jwerzowa/Lobo_Sat_EPS_V1/EPS_2S2P_KiCad_Kit/datasheets/README.md

# Datasheets

Put the PDFs here (Claude Code uses them to confirm pinouts). Suggested file names in brackets.
Links were correct when written; if one moved, search the manufacturer site for the MPN.

| Part | File | Source |
|---|---|---|
| LT3652 | `LT3652.pdf` | https://www.analog.com/media/en/technical-documentation/data-sheets/3652fe.pdf |
| S-8252 | `S-8252.pdf` | https://www.ablic.com/en/doc/datasheet/battery_protection/S8252_E.pdf |
| BQ29209 | `BQ29209.pdf` | https://www.ti.com/lit/ds/symlink/bq29209.pdf |
| FS8205A | `FS8205A.pdf` | Fortune Semiconductor (or the distributor page you bought from) |
| LMZM33602 | `LMZM33602.pdf` | https://www.ti.com/lit/ds/symlink/lmzm33602.pdf |
| TPS2553 | `TPS2553.pdf` | https://www.ti.com/lit/ds/symlink/tps2553.pdf |
| ADS1015 | `ADS1015.pdf` | https://www.ti.com/lit/ds/symlink/ads1015.pdf |
| ACS37612 | `ACS37612.pdf` | https://www.allegromicro.com (search ACS37612) |
| AO3400A / AO3401A | `AO3400A.pdf`, `AO3401A.pdf` | https://www.aosmd.com |
| LM393 | `LM393.pdf` | https://www.ti.com/lit/ds/symlink/lm393.pdf |
| SMBJ15A | `SMBJ.pdf` | Littelfuse SMBJ series |
| SS-5GL | `SS-5GL.pdf` | Omron SS series |
| 0466 fuse / 0ZCJ PTC | `0466.pdf`, `0ZCJ.pdf` | Littelfuse / Bel Fuse |
| NCP18XH103F03RB | `NCP18.pdf` | Murata |
| Keystone 18650 clip | `Keystone_18650.pdf` | Keystone Electronics (your exact MPN) |
| WSL2512, STPS140Z, CMSH3-40MA | as named | Vishay / ST / Central |
