jwerzowa/Lobo_Sat_EPS_V1/LINK_REPORT.md

# LINK_REPORT.md

Project: `/Users/julienwerzowa/Desktop/Projects/PCB/EPS_Lobosat_V1`

- Symbol libs in sym-lib-table: 1 | footprint libs in fp-lib-table: 1
- Symbols checked: 15 | with problems: 1

## Symbols

| Lib | Symbol | Footprint | Status | Notes |
|---|---|---|---|---|
| EPS_Symbols | 0ZCJ0100FF2E | EPS_Footprints:RESC3216X125N | OK |  |
| EPS_Symbols | 7447789004 | EPS_Footprints:WE-PD_7332R | OK |  |
| EPS_Symbols | ADS1015IRUGR | EPS_Footprints:IC_ADS1015IRUGR | OK |  |
| EPS_Symbols | BQ29209DRBR | EPS_Footprints:SON65P300X300X100-9N | OK |  |
| EPS_Symbols | CMSH3-40MA | EPS_Footprints:CR_SMA-CMSH3-40MA_CNS | OK |  |
| EPS_Symbols | FS8205A | EPS_Footprints:SOP65P640X120-8N | OK |  |
| EPS_Symbols | INA228AIDGSR | EPS_Footprints:VSSOP10_DGS_TEX | OK |  |
| EPS_Symbols | LMZM33602RLRR | EPS_Footprints:VREG_LMZM33602RLRR | OK | pads without pin (check EP/mounting): 12, 13 |
| EPS_Symbols | LT3652EMSE_PBF | EPS_Footprints:MSOP-12_MSE | OK |  |
| EPS_Symbols | NCP18XH103F03RB | EPS_Footprints:THRMC1608X95N | OK |  |
| EPS_Symbols | S-8252AAC-M6T1U | EPS_Footprints:SOT236-A-PKG_MP006-A-P-SD-2.1_ABL | OK |  |
| EPS_Symbols | SMBJ15A | EPS_Footprints:DIOM4336X265N | OK |  |
| EPS_Symbols | SS34 | EPS_Footprints:DIOM7959X265N | OK |  |
| EPS_Symbols | STPS140ZY | EPS_Footprints:SOD123_2P8X1P7_STM | OK |  |
| EPS_Symbols | TPS2553DBVR | Package_TO_SOT_SMD:SOT-23-6 | UNKNOWN FP LIB 'Package_TO_SOT_SMD' |  |
