jwerzowa/Lobo_Sat_EPS_V1/datasheets/README.md

# Datasheets

PDFs are **not committed** (gitignored). Run `bash scripts/fetch_datasheets.sh` to download the
ones that allow scripted downloads; get the rest by hand and save them here under the file name
shown. Claude Code uses them to confirm pinouts, so the more are here, the better.

| Part | File | Source | Auto-fetch |
|---|---|---|---|
| LT3652 | `LT3652.pdf` | https://www.analog.com/media/en/technical-documentation/data-sheets/3652fe.pdf | **No** (analog.com blocks scripts) |
| S-8252 | `S-8252.pdf` | https://www.ablic.com/en/doc/datasheet/battery_protection/S8252_E.pdf | yes |
| BQ29209 | `BQ29209.pdf` | https://www.ti.com/lit/ds/symlink/bq29209.pdf | yes |
| FS8205A | `FS8205A.pdf` | Fortune Semiconductor / the distributor you buy from | **No** |
| LMZM33602 | `LMZM33602.pdf` | https://www.ti.com/lit/ds/symlink/lmzm33602.pdf | yes |
| TPS2553 | `TPS2553.pdf` | https://www.ti.com/lit/ds/symlink/tps2553.pdf | yes |
| INA228 | `INA228.pdf` | https://www.ti.com/lit/ds/symlink/ina228.pdf | yes |
| ADS1015 | `ADS1015.pdf` | https://www.ti.com/lit/ds/symlink/ads1015.pdf | yes |
| AO3400A / AO3401A | `AO3400A.pdf`, `AO3401A.pdf` | https://www.aosmd.com | yes |
| LM393 | `LM393.pdf` | https://www.ti.com/lit/ds/symlink/lm393.pdf | yes |
| SS-5GL | `SS-5GL.pdf` | https://omronfs.omron.com/en_US/ecb/products/pdf/en-ss.pdf | yes |
| SMBJ15A | `SMBJ.pdf` | Littelfuse SMBJ series | No |
| 0466 fuse / 0ZCJ PTC | `0466.pdf`, `0ZCJ.pdf` | Littelfuse / Bel Fuse | No |
| NCP18XH103F03RB | `NCP18.pdf` | Murata | No (Murata blocks scripts) |
| Keystone 1042 18650 holder | `Keystone_1042.pdf` | Keystone Electronics | No |
| WSL2512, STPS140Z, CMSH3-40MA, SS34, 7447789004 | as named | Vishay / ST / Central / onsemi / Würth | No |
