jwerzowa/Lobo_Sat_EPS_V1/EPS_2S2P_KiCad_Kit/images/battery_protection_topology.png

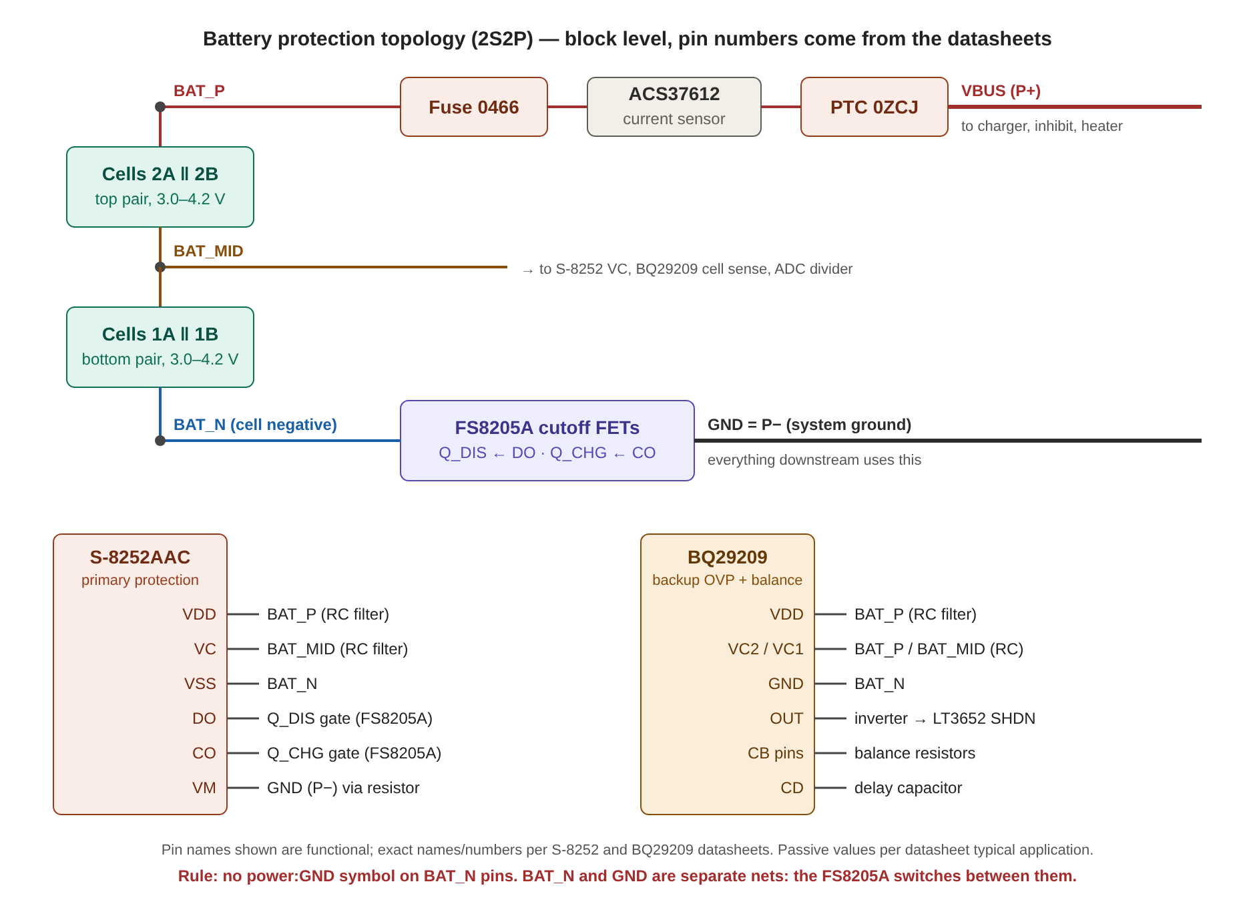
EPS_2S2P_KiCad_Kit/images/battery_protection_topology.png
