jwerzowa/Lobo_Sat_EPS_V1/MISSING_PARTS.md

# MISSING_PARTS.md

Generated by Claude Code on: 2026-10-23 (updated 2026-10-24: heater dropped)
KiCad version: 10.0.4
Library audit: `python3 scripts/audit_libs.py --project . --libs libs/symbols --out LINK_REPORT.md`
(15 symbols checked, all link symbol → footprint → 3D model. The one "problem" listed is TPS2553
using KiCad's built-in `Package_TO_SOT_SMD:SOT-23-6`, which the audit script can't see.)

## 1. Parts not found at all

| MPN | Needed for (sheet / function) | What's missing | Where to get it | Priority |
|---|---|---|---|---|
| SS-5GL (Omron) | launch_inhibit / RBF + deployment switch | footprint + 3D (symbol = KiCad `Switch:SW_SPDT`) | Omron / SnapEDA. Note SS-5GL has **solder** terminals; the PCB-terminal version is **SS-5GLD** | Blocking for layout |
| Keystone 18650 clip | battery / cell holders | exact MPN. Using KiCad's `Battery:BatteryHolder_Keystone_1042_1x18650` footprint | Keystone. Confirm 1042 is the holder you want | High |
| Littelfuse 0466 (rating TBD) | battery / main + per-cell fuses | rating → MPN. Using `Device:Fuse` + KiCad `Fuse_1206_3216Metric` | Littelfuse 0466 series | High |
| 2N7002-type N-FET ×2 | charger / SHDN inverters (Q201, Q202) | part choice (docs/06 #9). Placed as `Transistor_FET:2N7002`, Value = TBD | any SOT-23 logic-level N-FET, Vgs max ≥ 12 V | Medium |
| Connectors (solar in, 3 outputs, MCU) | solar_input, load_switches, telemetry | type (docs/06 #8). JST-PH 2-pin and 1×20 header used as **placeholders** | — | Medium |

## 2. Partially available

| MPN | Have | Missing | Workaround used |
|---|---|---|---|
| S-8252AAC-M6T1U | symbol + footprint downloaded for **S-8252AAZ**-M6T1U | AAC-specific download | Same SOT-23-6 pinout for the whole series (datasheet Table 6), so the symbol was renamed to AAC. **Not a part substitution**: BOM MPN is AAC (4.300 V / 2.400 V). AAZ would be 4.225 V |
| S-8252AAC, INA228, STPS140ZY, CMSH3-40MA | symbol, footprint | vendor 3D model | KiCad generic body (SOT-23-6, MSOP-10, SOD-123, SMA) copied to `libs/3d/` |
| TPS2553DBVR | datasheet | any symbol | Drawn in `consolidate_libs.py` from datasheet §6 (DBV: 1 IN, 2 GND, 3 EN, 4 FAULT, 5 ILIM, 6 OUT); KiCad SOT-23-6 footprint |
| SMBJ15A | footprint, 3D | symbol | Clone of KiCad `Device:D_Zener` (pin 1 = K) |
| 7447789004 | generic WE-PD 7332 symbol/footprint/3D | inductance confirmation | Value set to 4.7 µH from your old schematic. Check Würth datasheet: L and Isat ≥ 3 A |

## 3. Library problems (found and fixed in `scripts/consolidate_libs.py`, originals untouched)

| MPN | Problem | Evidence | Fix |
|---|---|---|---|
| BQ29209DRBR | Footprint thermal vias numbered 10–13, sitting inside EP pad 9 | They overlap pad 9 copper; datasheet: thermal pad = GND | Renumbered to pad 9 |
| CMSH3-40MA | Pins had no names, type "unspecified" | Symbol drawing: cathode bar on pin 1 side | Named 1 = K, 2 = A; type passive |
| STPS140ZY | Pin type "unspecified" | — | passive |
| S-8252 | VSS typed power_out, VM unspecified | datasheet Table 6 | VSS power_in, VM input |
| INA228AIDGSR | GND typed power_out | datasheet Table 5-1 | power_in |
| LT3652EMSE_PBF | BAT and VFB typed output | they are sense inputs | input |
| LMZM33602RLRR | ~50 duplicate VOUT/SW/PGND pins (thermal-via pads) all "output" → ERC conflicts | — | duplicates → passive, main VOUT → power_out |
| All parts | No footprint had a 3D model linked; symbols pointed at per-part footprint libs that weren't in any fp-lib-table | old ERC: 23 footprint_link_issues | One `EPS_Footprints` lib, `${KIPRJMOD}/libs/3d/...` paths |
| SS34 | Footprint is **SMC** (DIOM7959, 7.9 × 5.9 mm), parts list says SMA | footprint name / IPC size code | **Not fixed**: pick the package you will buy |
| SMBJ15A footprint | No polarity mark on silkscreen | footprint file | Not fixed: add a cathode mark when you lay out |

## 4. Datasheets missing from `datasheets/`

| MPN | Needed to confirm |
|---|---|
| LT3652 | **Most important.** SHDN threshold/abs max (R203 pull-up), TIMER cap value, boost cap value (0.1 µF used, some LT parts want 1 µF), VFB bias-current correction for the 154k/100k divider, 100 mV sense threshold. Pinout taken from the symbol + your earlier wiring |
| FS8205A | Pinout (1,8 D; 2,3 S1; 4 G1; 5 G2; 6,7 S2). Symbol drawing agrees, not checked against a datasheet |
| NCP18, 0466, 0ZCJ, Keystone, WSL2512, STPS140Z, CMSH3-40MA, SS34, 7447789004 | ratings only, pinouts are trivial |

## 5. Design questions raised while wiring

| Question | Sheet | What I did meanwhile |
|---|---|---|
| Old schematic had the **SMBJ15A TVS reversed** (K on GND) | solar_input | Fixed: K → VSOLAR_RAW |
| Old schematic had the **STPS140ZY boost diode reversed** (K on BAT) | charger | Fixed: A → VBUS, K → BOOST |
| Per-cell fuses "DNP by default" would leave every cell disconnected | battery | Fitted. Use a 0 Ω 1206 link if you don't want them |
| 5 V rail: LMZM33602 wants VIN ≥ 1.3 × VOUT = 6.5 V, pack goes down to 6.0 V | regulation | Built as asked; 5 V will drop out near empty. Consider over-discharge or a UVLO on EN |
| BQ29209 OUT is referenced to BAT_N, the inverter FET source is on GND (P−) | charger | OK while the FS8205A is on. If the charge FET is off, BAT_N and GND differ; check this case |
| S-8252 CO/DO swing to VDD (≤ 8.4 V); FS8205A Vgs max ±12 V | battery | OK, no action |
| Heater | — | Dropped 2026-10-24. J701 pin 17 (was HEATER_EN) is spare |
| ADS1015 AIN0 now measures VSOLAR (the kit's I_BAT input moved to the INA228) | telemetry | Divider 330k/47k |
| Old schematic had an extra CMSH3-40MA (CR3) from BAT to GND with no stated role | charger | Dropped. Tell me if it was meant as reverse-polarity protection |
