jwerzowa/Lobo_Sat_EPS_V1/EPS_2S2P_KiCad_Kit/templates/MISSING_PARTS.md

# MISSING_PARTS.md

Generated by Claude Code on: YYYY-MM-DD
KiCad version: x.y.z
Library audit run: `python3 scripts/audit_libs.py ...` (attach LINK_REPORT.md)

## 1. Parts not found at all

| MPN | Needed for (sheet / function) | What's missing (symbol / footprint / 3D) | Where to get it | Priority |
|---|---|---|---|---|
| e.g. S-8252AAC-M6T1U | battery / primary protection | symbol + footprint + 3D | SnapEDA, Ultra Librarian, ABLIC site | Blocking |

## 2. Partially available

| MPN | Have | Missing | Workaround used (if any) |
|---|---|---|---|
| e.g. BQ29209DRBR | symbol, footprint | 3D model | none, 3D view will show no body |

## 3. Library problems (found but wrong)

| MPN | Problem | Evidence | Suggested fix |
|---|---|---|---|
| e.g. LT3652EMSE#PBF | Symbol has no pin for exposed pad 13 | Footprint pad 13 exists, datasheet: EP = GND | Add pin 13 "GND_EP" to symbol |

## 4. Datasheets missing from `datasheets/`

| MPN | Needed to confirm |
|---|---|
| | |

## 5. Design questions raised while wiring

| Question | Sheet | What I did meanwhile |
|---|---|---|
| | | |
