jwerzowa/Lobo_Sat_EPS_V1/BOM.csv

Refs | Value | MPN | Manufacturer | Footprint | Qty | DNP | Description
BT301 | 18650 cell 1A | TBD (Keystone 1042?) | Keystone Electronics | Battery:BatteryHolder_Keystone_1042_1x18650 | 1 |  | LG MJ1 18650 in holder
BT302 | 18650 cell 1B | TBD (Keystone 1042?) | Keystone Electronics | Battery:BatteryHolder_Keystone_1042_1x18650 | 1 |  | LG MJ1 18650 in holder
BT303 | 18650 cell 2A | TBD (Keystone 1042?) | Keystone Electronics | Battery:BatteryHolder_Keystone_1042_1x18650 | 1 |  | LG MJ1 18650 in holder
BT304 | 18650 cell 2B | TBD (Keystone 1042?) | Keystone Electronics | Battery:BatteryHolder_Keystone_1042_1x18650 | 1 |  | LG MJ1 18650 in holder
C201 | 10uF 50V X7R | generic | generic | Capacitor_SMD:C_1210_3225Metric | 1 |  | VIN input cap
C202 | TBD | generic | generic | Capacitor_SMD:C_0805_2012Metric | 1 |  | TIMER cap: value per LT3652 datasheet
C203 | 0.1uF 25V X7R | generic | generic | Capacitor_SMD:C_0805_2012Metric | 1 |  | Boost cap (verify value vs datasheet)
C204 | 10uF 25V X7R | generic | generic | Capacitor_SMD:C_1206_3216Metric | 1 |  | BAT output cap
C301-C306,C601,C603,C605,C701-C705 | 0.1uF | generic | generic | Capacitor_SMD:C_0805_2012Metric | 14 |  | ADC input filter,ADS1015 VDD bypass,BQ29209 VC1-GND,BQ29209 VC2-VC1,BQ29209 VDD,IN bypass,INA228 VS bypass,S-8252 C1 (VDD-VSS),S-8252 C2 (VC-VSS)
C307 | 0.33uF | generic | generic | Capacitor_SMD:C_0805_2012Metric | 1 |  | BQ29209 delay ~3 s
C501 | 150pF | generic | generic | Capacitor_SMD:C_0805_2012Metric | 1 |  | CFF, rail A
C502,C503,C515,C516 | 4.7uF 50V X7R | generic | generic | Capacitor_SMD:C_1210_3225Metric | 4 |  | CIN (2 x 4.7 uF min)
C504-C507,C518-C521 | 22uF 25V X7R | generic | generic | Capacitor_SMD:C_1210_3225Metric | 8 |  | COUT
C517 | 100pF | generic | generic | Capacitor_SMD:C_0805_2012Metric | 1 |  | CFF, rail A
C602,C604,C606 | 10uF 16V X7R | generic | generic | Capacitor_SMD:C_1206_3216Metric | 3 |  | Output cap
D101 | SMBJ15A | SMBJ15A | Littelfuse | EPS_Footprints:DIOM4336X265N | 1 |  | 15 V standoff unidirectional TVS, SMB (pin 1 = K)
D102 | SS34 | SS34 | onsemi | EPS_Footprints:DIOM7959X265N | 1 |  | 40 V 3 A Schottky. NOTE footprint is SMC (7.9 x 5.9 mm), parts list says SMA
D201 | CMSH3-40MA | CMSH3-40MA TR13 PBFREE | Central Semiconductor | EPS_Footprints:CR_SMA-CMSH3-40MA_CNS | 1 |  | Catch diode
D202 | STPS140ZY | STPS140ZY | STMicroelectronics | EPS_Footprints:SOD123_2P8X1P7_STM | 1 |  | Boost diode, BAT -> BOOST
F301-F305 | TBD | 0466 series (rating TBD) | Littelfuse | Fuse:Fuse_1206_3216Metric | 5 |  | Main pack fuse,Per-cell fuse 1A,Per-cell fuse 1B,Per-cell fuse 2A,Per-cell fuse 2B
F306 | 0ZCJ0100FF2E | 0ZCJ0100FF2E | Bel Fuse | EPS_Footprints:RESC3216X125N | 1 |  | PTC, hold current may be too low (docs/06 #4)
J101 | SOLAR_IN | TBD | TBD | Connector_JST:JST_PH_B2B-PH-K_1x02_P2.00mm_Vertical | 1 |  | Solar panel input, 1 = +, 2 = -. Connector TBD
J601 | OUT_VID | TBD | TBD | Connector_JST:JST_PH_B2B-PH-K_1x02_P2.00mm_Vertical | 1 |  | VID output, 1 = +, 2 = GND. Connector TBD
J602 | OUT_TLM | TBD | TBD | Connector_JST:JST_PH_B2B-PH-K_1x02_P2.00mm_Vertical | 1 |  | TLM output, 1 = +, 2 = GND. Connector TBD
J603 | OUT_COM | TBD | TBD | Connector_JST:JST_PH_B2B-PH-K_1x02_P2.00mm_Vertical | 1 |  | COM output, 1 = +, 2 = GND. Connector TBD
J701 | MCU_IF | TBD | TBD | Connector_PinHeader_2.54mm:PinHeader_1x20_P2.54mm_Vertical | 1 |  | MCU / OBC interface, placeholder footprint
L201 | 4.7uH | 7447789004 | Wurth Elektronik | EPS_Footprints:WE-PD_7332R | 1 |  | WE-PD 7332 power inductor (verify 4.7 uH / Isat >= 3 A)
Q201,Q202 | TBD | TBD | TBD | Package_TO_SOT_SMD:SOT-23 | 2 |  | BQ29209 OVP -> SHDN inverter (docs/06 #9),MCU charger shutdown (docs/06 #9)
Q301 | FS8205A | FS8205A | Fortune Semiconductor | EPS_Footprints:SOP65P640X120-8N | 1 |  | Dual N-MOSFET common drain, TSSOP-8 (1,8 D; 2,3 S1; 4 G1; 5 G2; 6,7 S2)
Q401 | AO3401A | AO3401A | Alpha & Omega | Package_TO_SOT_SMD:SOT-23 | 1 |  | -4.0A Id, -30V Vds, P-Channel MOSFET, SOT-23
R201-R203,R601,R603,R605 | TBD | generic | generic | Resistor_SMD:R_0805_2012Metric | 6 |  | ILIM COM (docs/06 #5),ILIM TLM (docs/06 #5),ILIM VID (docs/06 #5),SHDN pull-up; check LT3652 SHDN threshold/abs max,VIN_REG divider bottom (docs/06 #3),VIN_REG divider top (docs/06 #3)
R204 | 1k | generic | generic | Resistor_SMD:R_0805_2012Metric | 1 |  | Gate series R, per BQ29209 Fig. 9
R205,R206,R401,R602,R604,R606 | 100k | generic | generic | Resistor_SMD:R_0805_2012Metric | 6 |  | Charger enabled while MCU is off,EN pull-down,Gate pull-down,Gate pull-up, FET off by default
R207 | 154k 1% | generic | generic | Resistor_SMD:R_0805_2012Metric | 1 |  | Float divider top
R208 | 100k 1% | generic | generic | Resistor_SMD:R_0805_2012Metric | 1 |  | Float divider bottom
R209 | 50m 1% | WSL2512R0500FEA | Vishay Dale | Resistor_SMD:R_2512_6332Metric | 1 |  | Charge current sense
R301 | 10m 1% | WSL2512R0100FEA | Vishay Dale | Resistor_SMD:R_2512_6332Metric | 1 |  | INA228 shunt (value proposed, confirm with fuse rating)
R302,R303 | 470 | generic | generic | Resistor_SMD:R_0805_2012Metric | 2 |  | S-8252 R1,S-8252 R2
R304 | 2k | generic | generic | Resistor_SMD:R_0805_2012Metric | 1 |  | S-8252 R3 (VM to EB-)
R305 | 160 | generic | generic | Resistor_SMD:R_0805_2012Metric | 1 |  | BQ29209 RCB2
R306 | 261 1% | generic | generic | Resistor_SMD:R_0805_2012Metric | 1 |  | BQ29209 RCB1 (datasheet 260)
R307,R308 | 100 | generic | generic | Resistor_SMD:R_0805_2012Metric | 2 |  | BQ29209 RCB,BQ29209 RVD
R309,R503,R509 | 10k 1% | generic | generic | Resistor_SMD:R_0805_2012Metric | 3 |  | NTC divider, ADS1015 supply as reference,RFBB, rail A
R501 | 133k 1% | generic | generic | Resistor_SMD:R_0805_2012Metric | 1 |  | RT, rail A
R502 | 23.2k 1% | generic | generic | Resistor_SMD:R_0805_2012Metric | 1 |  | RFBT, rail A = 3V3
R507 | 40.2k 1% | generic | generic | Resistor_SMD:R_0805_2012Metric | 1 |  | RFBT, rail A = 3V3
R508 | 88.7k 1% | generic | generic | Resistor_SMD:R_0805_2012Metric | 1 |  | RT, rail A
R701 | 330k 0.1% | generic | generic | Resistor_SMD:R_0805_2012Metric | 1 |  | VSOLAR divider top
R702 | 47k 0.1% | generic | generic | Resistor_SMD:R_0805_2012Metric | 1 |  | VSOLAR divider bottom
R703 | 200k 0.1% | generic | generic | Resistor_SMD:R_0805_2012Metric | 1 |  | VBUS divider top
R704-R706 | 100k 0.1% | generic | generic | Resistor_SMD:R_0805_2012Metric | 3 |  | BAT_MID divider bottom,BAT_MID divider top,VBUS divider bottom
R707-R715 | 10k | generic | generic | Resistor_SMD:R_0805_2012Metric | 9 |  | Pull-up ADC_ALERT_N,Pull-up CHG_FAULT_N,Pull-up CHG_STAT_N,Pull-up FLT_COM_N,Pull-up FLT_TLM_N,Pull-up FLT_VID_N,Pull-up INA_ALERT_N,Pull-up PG_RAIL_A,Pull-up PG_RAIL_B
R716,R717 | 4.7k | generic | generic | Resistor_SMD:R_0805_2012Metric | 2 |  | I2C pull-up
SW401 | SS-5GL | SS-5GL | Omron |  | 1 |  | Deployment / RBF microswitch, 2 = COM, 1 = NC, 3 = NO
TH201,TH301 | 10k NTC | NCP18XH103F03RB | Murata | EPS_Footprints:THRMC1608X95N | 2 |  | Charge NTC, mount against the cells,Telemetry NTC, mount against the cells
U201 | LT3652EMSE#PBF | LT3652EMSE#PBF | Analog Devices | EPS_Footprints:MSOP-12_MSE | 1 |  | Solar MPPT Li-ion charger, MSOP-12 exposed pad (pin 13 = EP = GND)
U301 | INA228 | INA228AIDGSR | Texas Instruments | EPS_Footprints:VSSOP10_DGS_TEX | 1 |  | 85 V 20-bit I2C power/energy/charge monitor, VSSOP-10
U302 | S-8252AAC-M6T1U | S-8252AAC-M6T1U | ABLIC | EPS_Footprints:SOT236-A-PKG_MP006-A-P-SD-2.1_ABL | 1 |  | 2-cell Li-ion protection, OC 4.300 V, OD 2.400 V, SOT-23-6
U303 | BQ29209DRBR | BQ29209DRBR | Texas Instruments | EPS_Footprints:SON65P300X300X100-9N | 1 |  | 2-cell backup overvoltage protection (4.30 V) + cell balancing, VSON-8
U501,U503 | LMZM33602 3V3 | LMZM33602RLRR | Texas Instruments | EPS_Footprints:VREG_LMZM33602RLRR | 2 |  | 36 V 2 A buck power module, QFN-18 (pads 12/13 = DNC, no symbol pin on purpose)
U601-U603 | TPS2553DBVR | TPS2553DBVR | Texas Instruments | Package_TO_SOT_SMD:SOT-23-6 | 3 |  | Current-limited load switch, EN active high, auto-retry, SOT-23-6
U701 | ADS1015 | ADS1015IRUGR | Texas Instruments | EPS_Footprints:IC_ADS1015IRUGR | 1 |  | 4-ch 12-bit I2C ADC, X2QFN-10
