jwerzowa/Lobo_Sat_EPS_V1/docs/05_parts_list.csv

Sheet | RefPrefix | MPN | Manufacturer | Description | Package | Qty | Library | DNP | Notes
solar_input | J | TBD | TBD | Solar panel input connector 2-pin | TBD | 1 | either | no | Connector type not chosen; use generic Conn_01x02 + note
solar_input | D | SMBJ15A | Littelfuse | TVS diode 15 V | SMB (DO-214AA) | 1 | downloaded | no | Panel Voc must stay below 15 V
solar_input | D | SS34 | generic | Schottky 3 A 40 V backfeed block | SMA (DO-214AC) | 1 | downloaded | no | One per panel string
charger | U | LT3652EMSE#PBF | Analog Devices | Solar MPPT Li-ion charger | MSOP-12 exposed pad | 1 | downloaded | no | EP to GND
charger | L | TBD | TBD | Power inductor ~4.7 uH >=3 A | TBD | 1 | either | no | Value per LT3652 datasheet
charger | D | STPS140ZY | STMicroelectronics | Boost diode | SOD-123 | 1 | downloaded | no
charger | D | CMSH3-40MA | Central Semiconductor | Schottky catch diode 3 A 40 V | SMA | 1 | downloaded | no | Confirm role vs SS34 in schematic
charger | C | TBD | generic | 0.1 uF >=16 V boost capacitor | 0805 | 1 | builtin | no
charger | R | WSL2512R0500FEA | Vishay | Charge current sense resistor 50 mOhm | 2512 | 1 | downloaded | no
charger | R | TBD | generic | Float divider top 154 kOhm 1% | 0805 | 1 | builtin | no
charger | R | TBD | generic | Float divider bottom 100 kOhm 1% | 0805 | 1 | builtin | no
charger | R | TBD | generic | VIN_REG divider top (value TBD) | 0805 | 1 | builtin | no | Old 143k is WRONG for 2S
charger | R | TBD | generic | VIN_REG divider bottom (value TBD) | 0805 | 1 | builtin | no
charger | Q | TBD | generic | N-FET SHDN inverters (BQ29209 OVP + MCU) | SOT-23 | 2 | builtin | no | docs/06 #9
charger | TH | NCP18XH103F03RB | Murata | NTC 10 kOhm charge temperature | 0603 | 1 | downloaded | no | Mounted against cells
battery | BT | TBD | Keystone Electronics | 18650 battery clip/holder | per downloaded part | 4 | downloaded | no | Exact Keystone MPN from Julien's library
battery | U | S-8252AAC-M6T1U | ABLIC | 2-cell Li-ion protection (primary) | SOT-23-6 | 1 | downloaded | no | Do NOT substitute AAJ/AAL
battery | Q | FS8205A | Fortune Semiconductor | Dual N-MOSFET common drain (cutoff) | TSSOP-8 or SOT-23-6 (check library) | 1 | downloaded | no
battery | U | BQ29209DRBR | Texas Instruments | 2-cell backup OVP + cell balancing | VSON-8 3x3 exposed pad (DRB) | 1 | downloaded | no | EP per datasheet
battery | F | 0466-series | Littelfuse | Main hard fuse fast-acting | 1206 | 1 | downloaded | no | Rating TBD from max bus current
battery | F | 0466-series | Littelfuse | Per-cell fuse (optional) | 1206 | 4 | downloaded | yes | DNP by default
battery | F | 0ZCJ0100FF2E | Bel Fuse | PTC resettable 1 A hold | 1206 | 1 | downloaded | no | Hold current may be too low; see open questions
battery | U | INA228AIDGSR | Texas Instruments | Power/energy monitor battery path (replaces ACS37612) | VSSOP-10 | 1 | downloaded | no | I2C 0x40
battery | R | WSL2512R0100FEA | Vishay | INA228 shunt 10 mOhm (proposed) | 2512 | 1 | builtin | no | Confirm with fuse rating
battery | TH | NCP18XH103F03RB | Murata | NTC 10 kOhm telemetry temperature | 0603 | 1 | downloaded | no | Mounted against cells
battery | R/C | per datasheet | generic | S-8252 and BQ29209 RC filters + VM resistor + delay cap + balance resistors | 0805 | TBD | builtin | no | Values from datasheet typical circuit
launch_inhibit | Q | AO3401A | Alpha & Omega | P-MOSFET bus disconnect | SOT-23 | 1 | downloaded | no
launch_inhibit | SW | SS-5GL | Omron | Deployment / RBF microswitch | per downloaded part | 1 | downloaded | no | Count per launch provider
launch_inhibit | R | TBD | generic | Gate pull-up 100 kOhm | 0805 | 1 | builtin | no
regulation | U | LMZM33602RLRR | Texas Instruments | Buck power module 2 A | QFN module (RLR) | 2 | downloaded | no | FB divider values TBD
regulation | C/R | per datasheet | generic | LMZM33602 input/output caps and FB divider | 0805/0805/1206 | TBD | builtin | no
load_switches | U | TPS2553 | Texas Instruments | Current-limited load switch | SOT-23-6 | 3 | downloaded | no | Check -1 variant EN polarity
load_switches | R | TBD | generic | ILIM resistor (value TBD) | 0805 | 3 | builtin | no
load_switches | J | TBD | TBD | Subsystem output connector 2-pin | TBD | 3 | either | no | Videography / Telemetry / Comms
telemetry | U | ADS1015IRUGR | Texas Instruments | 4-ch 12-bit I2C ADC | X2QFN-10 (RUG) | 1 | downloaded | no | Very small leadless package
telemetry | R | per schematic | generic | ADC voltage dividers + pull-ups | 0805 | 17 | builtin | no
telemetry | J | TBD | TBD | MCU / OBC interface connector | TBD | 1 | either | no | Pin order up to Claude; document it
