jwerzowa/Lobo_Sat_EPS_V1/EPS_Lobosat_V1.kicad_pcb

## KiCad design electrical/kicad/3_trigger_sensor/3_trigger_sensor.kicad_sch

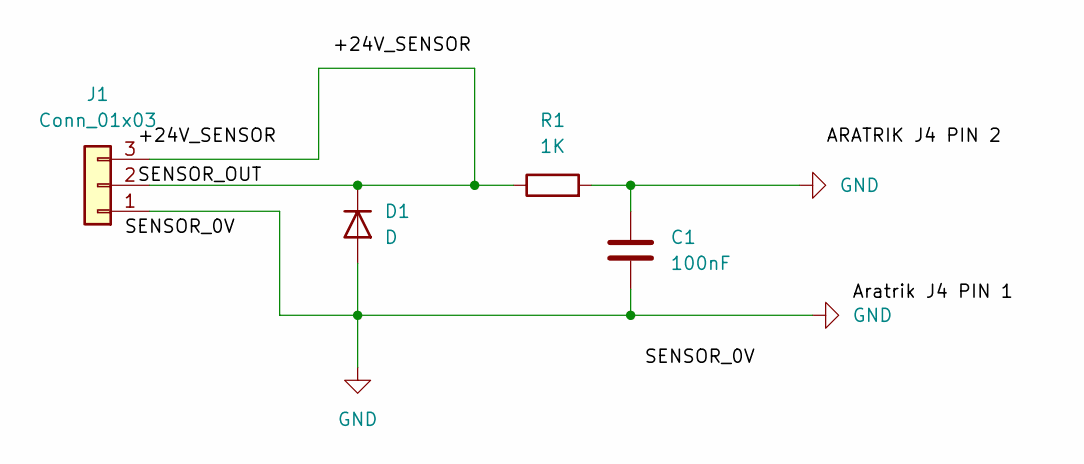
[picture p3: schematic 3_trigger_sensor.kicad_sch]

Parts:
C1: 100nF
D1: D; WSON-8-1EP_6x5mm_P1.27mm_EP3.4x4mm
J1: Conn_01x03; TO-263-9_TabPin5
R1: 1K

Connections:
GND: C1.1, C1.2, D1.2 (A), J1.1, R1.2
unnamed: D1.1 (K), J1.2, J1.3, R1.1
