jwerzowa/Lobo_Sat_EPS_V1/EPS_Lobosat_V1.kicad_pcb

## KiCad design electrical/kicad/4_indicator_driver/4_indicator_driver.kicad_sch

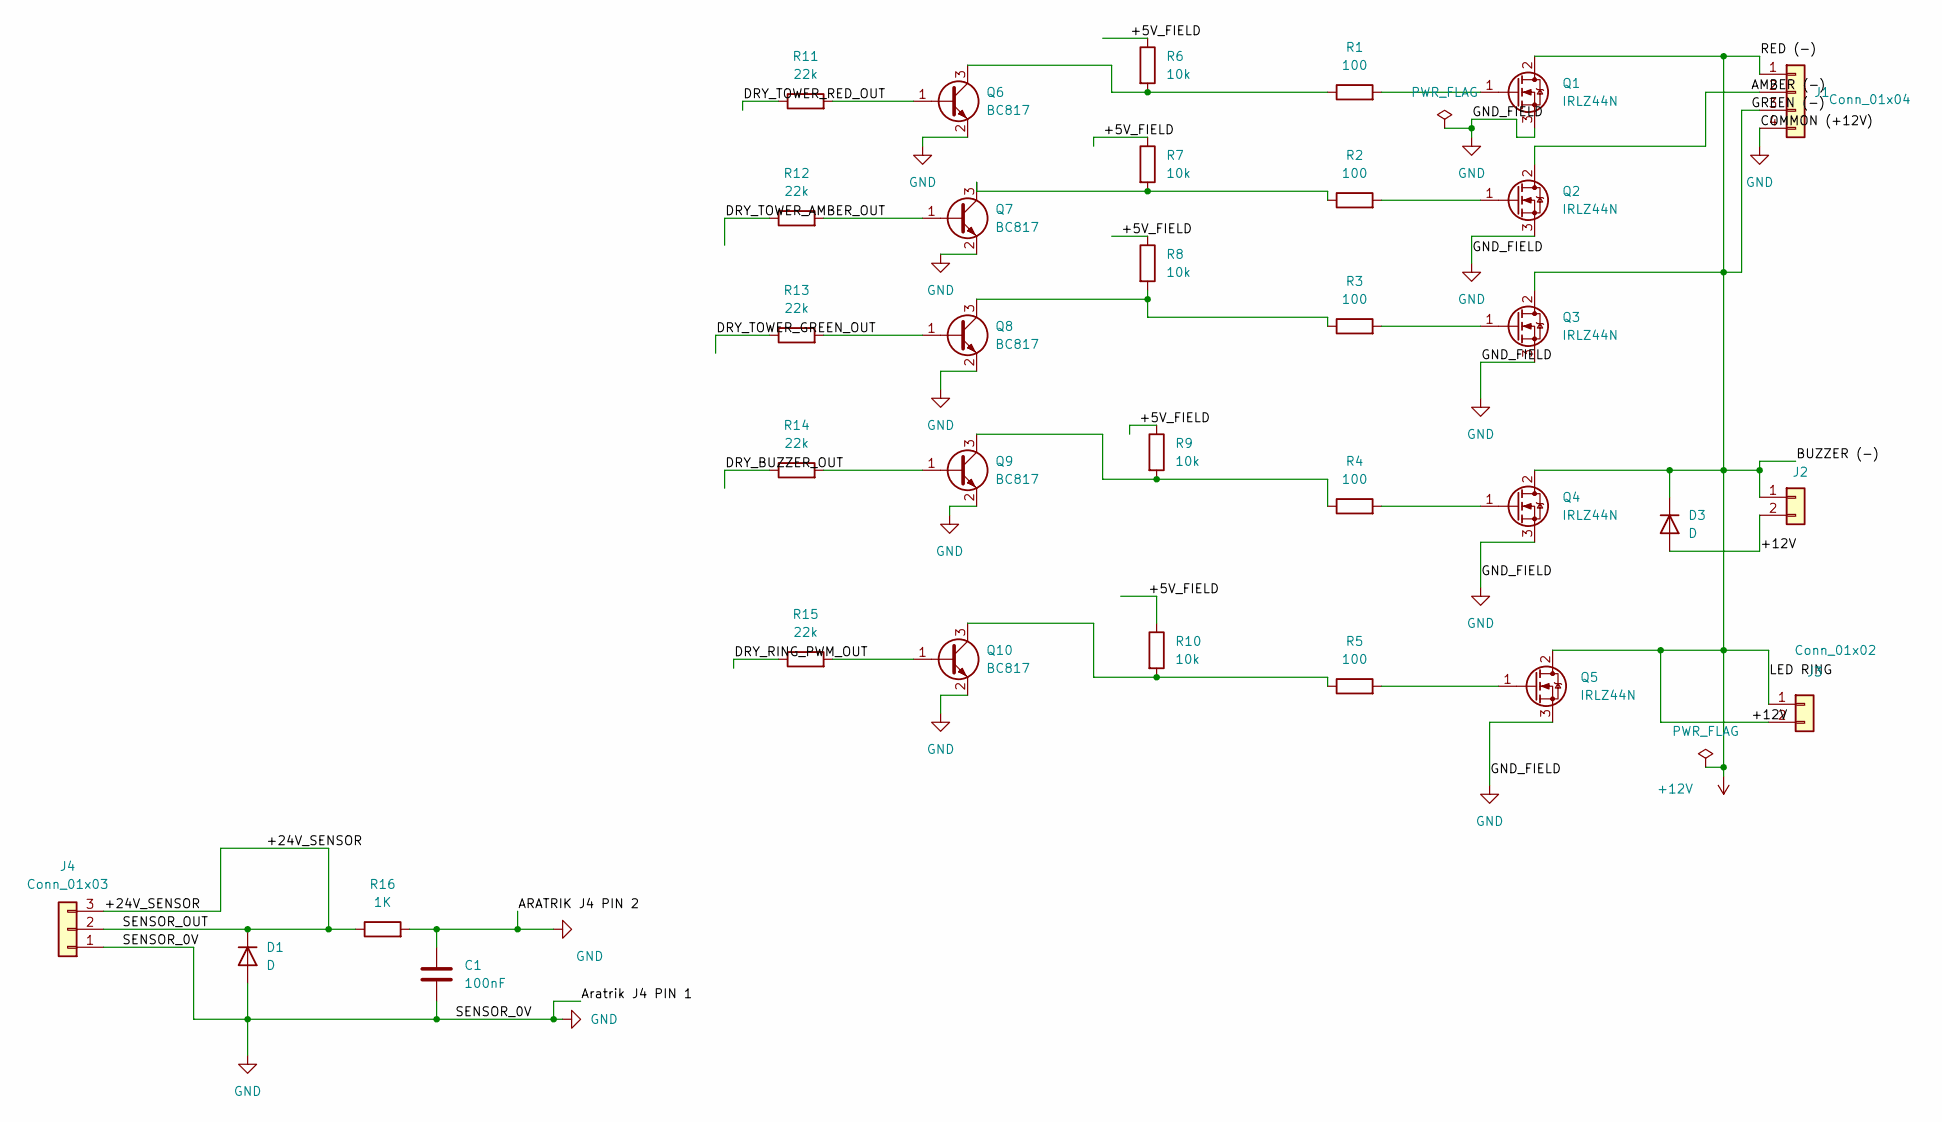
[picture p4: schematic 4_indicator_driver.kicad_sch]

Parts:
C1: 100nF
D1: D; WSON-8-1EP_6x5mm_P1.27mm_EP3.4x4mm
D3: D
J1: Conn_01x04
J2, J3: Conn_01x02
J4: Conn_01x03; TO-263-9_TabPin5
Q1, Q2, Q3, Q4, Q5: IRLZ44N; TO-220-3_Vertical
Q6, Q7, Q8, Q9, Q10: BC817; SOT-23
R1, R2, R3, R4, R5: 100; TO-220-3_Vertical
R6, R7, R8, R9, R10: 10k
R11, R12, R13, R14, R15: 22k; SOT-23
R16: 1K

Connections:
+5V_FIELD: R6.1, R7.1, R8.1, R9.1, R10.1
+12V: D3.1 (K), D3.2 (A), J1.1, J1.3, J2.1, J2.2, J3.1, J3.2, Q1.2 (D), Q3.2 (D), Q4.2 (D), Q5.2 (D)
+24V_SENSOR: D1.1 (K), J4.2, J4.3, R16.1
AMBER (-): J1.2, Q2.2 (D)
DRY_BUZZER_OUT: R14.1
DRY_RING_PWM_OUT: R15.1
DRY_TOWER_AMBER_OUT: R12.1
DRY_TOWER_GREEN_OUT: R13.1
DRY_TOWER_RED_OUT: R11.1
GND: C1.1, C1.2, D1.2 (A), J1.4, J4.1, Q1.3 (S), Q2.3 (S), Q3.3 (S), Q4.3 (S), Q5.3 (S), Q6.2 (E), Q7.2 (E), Q8.2 (E), Q9.2 (E), Q10.2 (E), R16.2
unnamed: Q1.1 (G), R1.2
unnamed: Q2.1 (G), R2.2
unnamed: Q3.1 (G), R3.2
unnamed: Q4.1 (G), R4.2
unnamed: Q5.1 (G), R5.2
unnamed: Q6.1 (B), R11.2
unnamed: Q6.3 (C), R1.1, R6.2
unnamed: Q7.1 (B), R12.2
unnamed: Q7.3 (C), R2.1, R7.2
unnamed: Q8.1 (B), R13.2
unnamed: Q8.3 (C), R3.1, R8.2
unnamed: Q9.1 (B), R14.2
unnamed: Q9.3 (C), R4.1, R9.2
unnamed: Q10.1 (B), R15.2
unnamed: Q10.3 (C), R5.1, R10.2
