jwerzowa/Lobo_Sat_EPS_V1/EPS_Lobosat_V1.kicad_pcb

## KiCad design electrical/kicad/ForgeSight_Power_Isolation/ForgeSight_Power_Isolation.kicad_sch

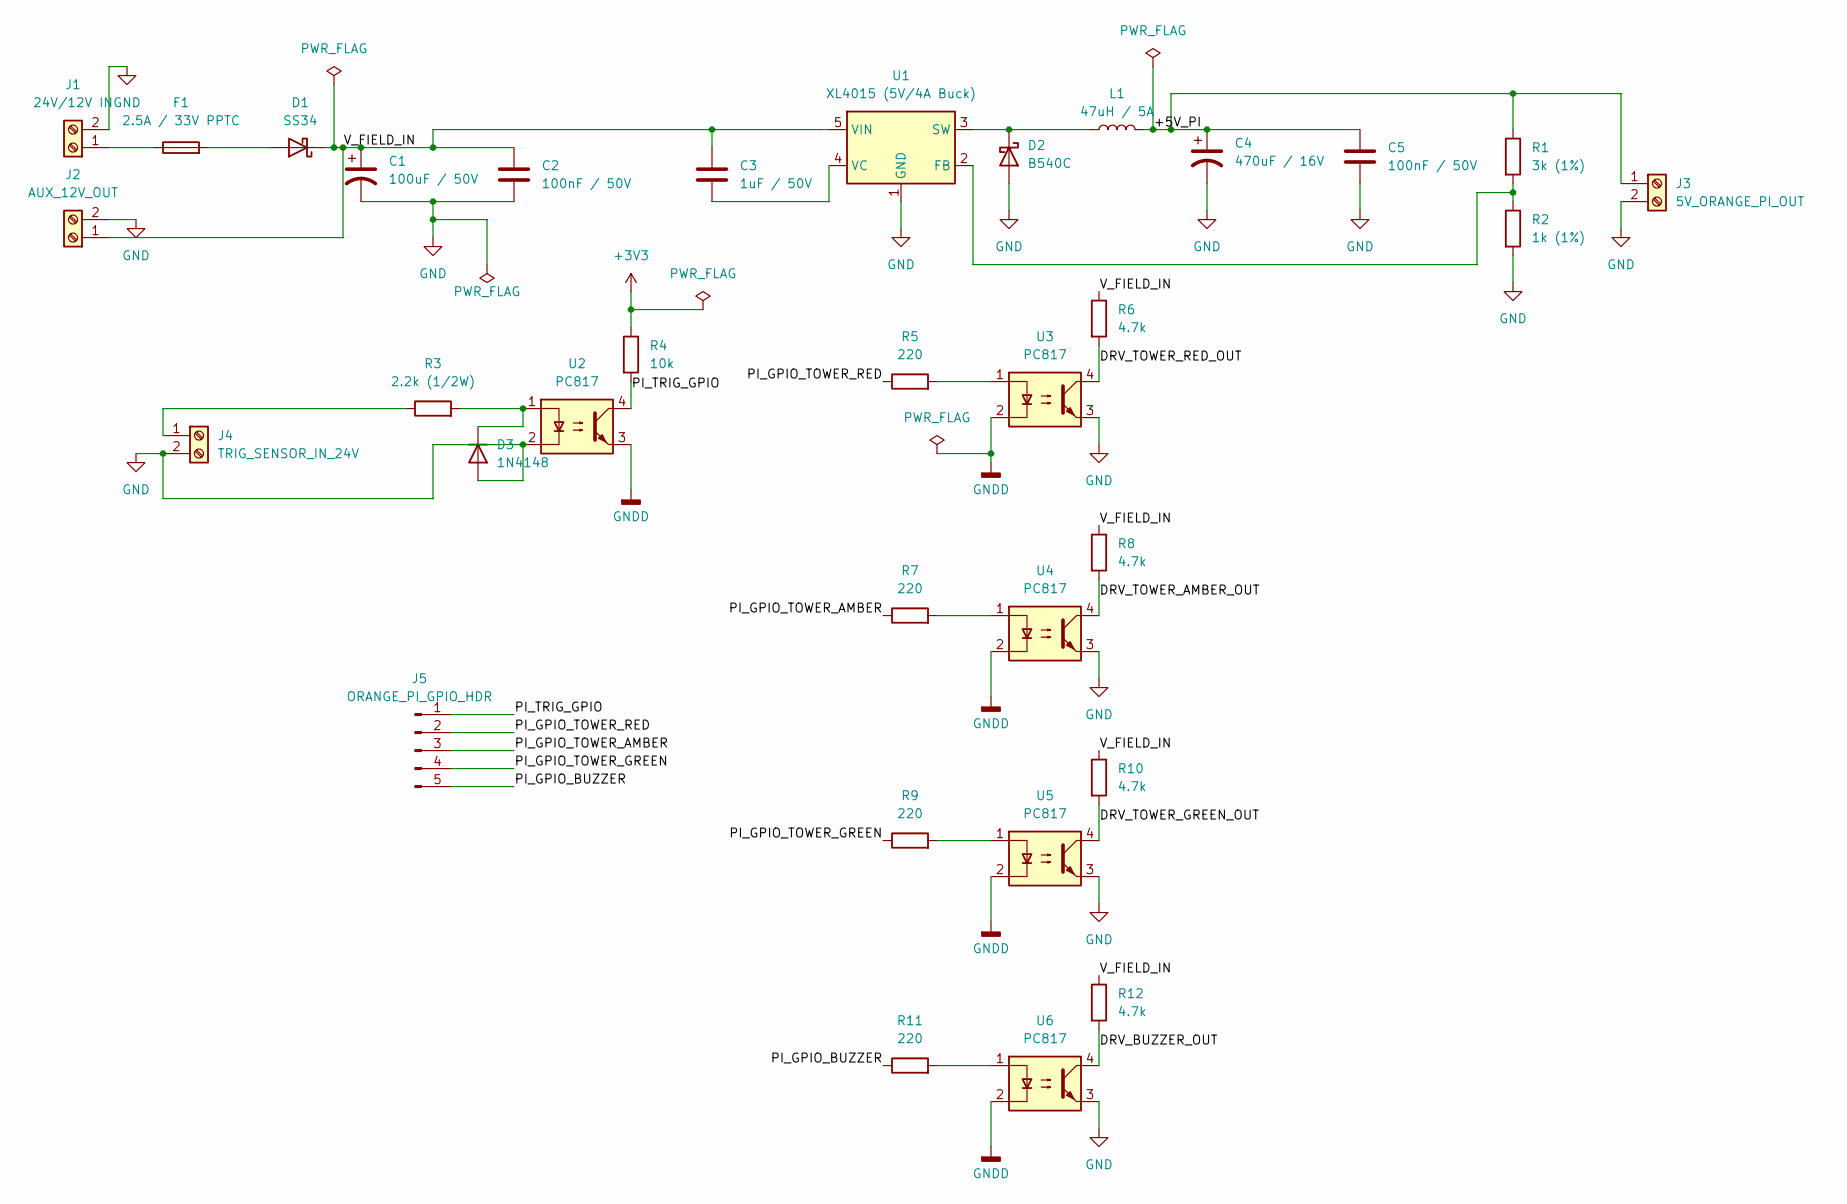
[picture p5: schematic ForgeSight_Power_Isolation.kicad_sch]

Parts:
C1: 100uF / 50V
C2, C5: 100nF / 50V
C3: 1uF / 50V
C4: 470uF / 16V
D1: SS34
D2: B540C; TO-263-5_TabPin3
D3: 1N4148; D_DO-35_SOD27_P7.62mm_Horizontal
F1: 2.5A / 33V PPTC
J1: 24V/12V IN
J2: AUX_12V_OUT
J3: 5V_ORANGE_PI_OUT
J4: TRIG_SENSOR_IN_24V; D_DO-35_SOD27_P7.62mm_Horizontal
J5: ORANGE_PI_GPIO_HDR
L1: 47uH / 5A
R1: 3k (1%)
R2: 1k (1%)
R3: 2.2k (1/2W); DIP-4_W7.62mm
R4: 10k; DIP-4_W7.62mm
R5, R7, R9, R11: 220; DIP-4_W7.62mm
R6, R8, R10, R12: 4.7k; DIP-4_W7.62mm
U1: XL4015 (5V/4A Buck); TO-263-5_TabPin3
U2, U3, U4, U5, U6: PC817; DIP-4_W7.62mm

Connections:
+3V3: R4.1
+5V_PI: C4.1, C5.1, J3.1, L1.2, R1.1
DRV_BUZZER_OUT: R12.2, U6.4
DRV_TOWER_AMBER_OUT: R8.2, U4.4
DRV_TOWER_GREEN_OUT: R10.2, U5.4
DRV_TOWER_RED_OUT: R6.2, U3.4
GND: C1.2, C2.2, C4.2, C5.2, D2.2 (A), D3.2 (A), J1.2, J2.2, J3.2, J4.2, R2.2, U1.1 (GND), U2.2, U3.3, U4.3, U5.3, U6.3
GNDD: U2.3, U3.2, U4.2, U5.2, U6.2
unnamed: C3.2, U1.4 (VC)
unnamed: D1.2 (A), F1.2
unnamed: D2.1 (K), L1.1, U1.3 (SW)
unnamed: D3.1 (K), R3.2, U2.1
unnamed: F1.1, J1.1
unnamed: J4.1, R3.1
unnamed: R1.2, R2.1, U1.2 (FB)
unnamed: R5.2, U3.1
unnamed: R7.2, U4.1
unnamed: R9.2, U5.1
unnamed: R11.2, U6.1
PI_GPIO_BUZZER: J5.5, R11.1
PI_GPIO_TOWER_AMBER: J5.3, R7.1
PI_GPIO_TOWER_GREEN: J5.4, R9.1
PI_GPIO_TOWER_RED: J5.2, R5.1
PI_TRIG_GPIO: J5.1, R4.2, U2.4
V_FIELD_IN: C1.1, C2.1, C3.1, D1.1 (K), J2.1, R6.1, R8.1, R10.1, R12.1, U1.5 (VIN)
