jwerzowa/Lobo_Sat_EPS_V1/(commit log)

2026-09-21 intial commit, Schematic for Solar panel, mppt, and battery, missing telemetry components wired up
    [EPS_Lobosat_V1.kicad_pcb, EPS_Lobosat_V1.kicad_sch]
2026-09-21 Enhance README with project details and specifications
    Expanded the README to provide detailed information about the LOBOSAT EPS Board, including its design goals, functionalities, current status, and parts list.
2026-10-02 new Battery ICs: BQ29209 and the S-8252
    [EPS_Lobosat_V1.kicad_sch]
2026-10-02 Change battery protection ICs in README
    Updated battery protection components in the README.
2026-10-02 Change current/temp reporting method in README
    Updated the reporting method for battery/solar current and temperature to use the INA228.
2026-10-02 Revise charging setup and schematic status in README
    Updated charging configuration from 1S2P to 2S2P and refined schematic status description.
2026-10-02 Fix typo and update schematic status in README
    Corrected a typo and clarified the status of the schematic work.
2026-10-23 Snapshot: last hand-drawn schematic + Claude desktop kit, before restructure
2026-10-23 Reorganize repo to kit layout; consolidate and link libraries
    - Move Claude desktop kit (CLAUDE.md, docs, scripts, .claude) to project root
    - Vendor downloads -> libs/_downloads (untouched); build EPS_Symbols /
    EPS_Footprints.pretty / libs/3d with scripts/consolidate_libs.py
    - Add fp-lib-table; sym-lib-table now one ${KIPRJMOD} library
    - Fix BQ29209 footprint thermal vias (pads 10-13 -> EP pad 9)
    - Add TPS2553DBVR and SMBJ15A symbols; S-8252 symbol renamed to AAC variant
    - Link 3D models for every part; stop tracking .history, .DS_Store, .kicad_prl
2026-10-23 Generate hierarchical schematic (8 sheets) from scripts/gen_schematic.py
    - One sheet per block: solar_input, charger, battery, launch_inhibit,
    regulation, load_switches, telemetry, heater (DNP)
    - Telemetry: INA228 + shunt in pack path, ADS1015 (ACS37612 dropped)
    - Rails: 3.3 V / 5 V, LMZM33602 FB/RT/CFF from datasheet Table 7-1
    - Fixes vs old flat schematic: TVS and boost diode were reversed
    - ERC 0 violations; netlist matches expected_nets.json exactly
    - Vendor pin-type fixes, deterministic footprint UUIDs, datasheet fetch script
    - MISSING_PARTS.md, docs/CLAUDE.md/README updated for the decisions
2026-10-23 Flatten schematic to a single A0 sheet
    All 8 blocks on EPS_Lobosat_V1.kicad_sch, each in a titled dashed box;
    local labels instead of global labels; sheets/ removed. Docs updated.
    ERC 0 violations, netlist still matches expected_nets.json exactly.
2026-10-24 Hand-tidied single-sheet schematic, drop heater, add BOM and README
    - Schematic tidied by hand in KiCad (one A0 sheet); rail B regulator block
    rebuilt (now U503 + R507-R509, C515-C521), heater block removed
    - Fixed copy-paste labels on U503: SW pins were on REGA_SW (shorted both
    regulators' switch nodes) and PGOOD on PG_RAIL_A
    - ERC 0 violations; expected_nets.json reset to the verified netlist
    - BOM.csv exported from the schematic (62 lines, 121 parts)
    - README: what changed, why values are TBD, full BOM table
    - Generator retired to scripts/archive/ (would overwrite manual edits)
2026-10-24 Switch small resistors and capacitors from 0603 to 0805
    65 parts (46 R, 19 C) for easier hand soldering. 1206/1210 bulk caps,
    2512 shunts, 1206 fuses and 0603 NCP18 thermistors unchanged.
    ERC 0 violations, netlist unchanged (check_netlist PASS), BOM re-exported.
